JWehle/jannett-kicad-libraries/README.md

# jannett-kicad-libraries
Footprint and symbol libraries for my KiCad projects.
