JWehle/jannett-kicad-libraries/jannett_3d_models/RCJ-024.step

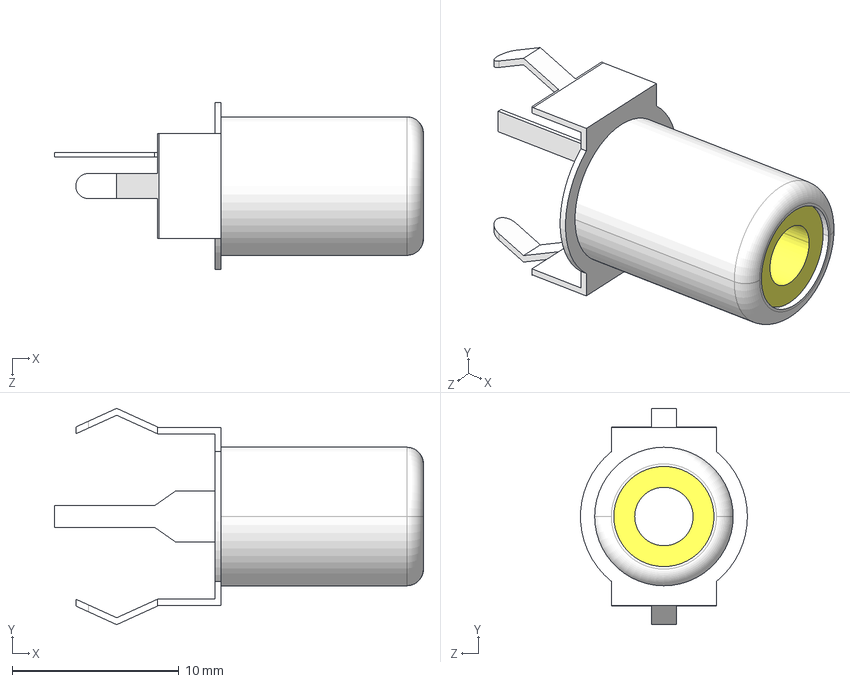
[picture p2: CAD file, 2026-07-09]
jannett_3d_models/RCJ-024.step
22.1 x 13.0 x 9.99 mm
