JWehle/jannett-kicad-libraries/jannett_3d_models/EPC2204.step

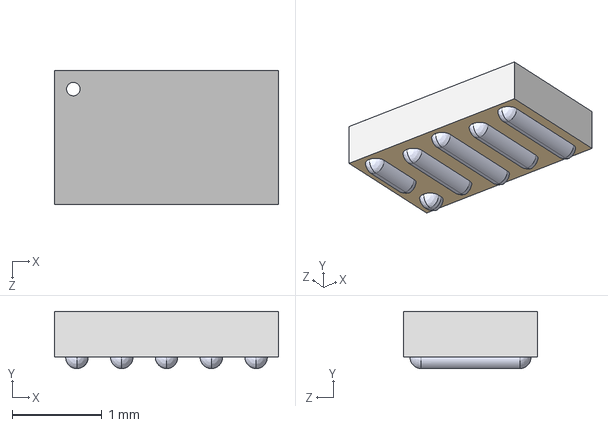
[picture p3: CAD file, 2026-03-19]
jannett_3d_models/EPC2204.step
2.50 x 0.638 x 1.50 mm
