JWehle/jannett-kicad-libraries/jannett_3d_models/EPC2218A.step

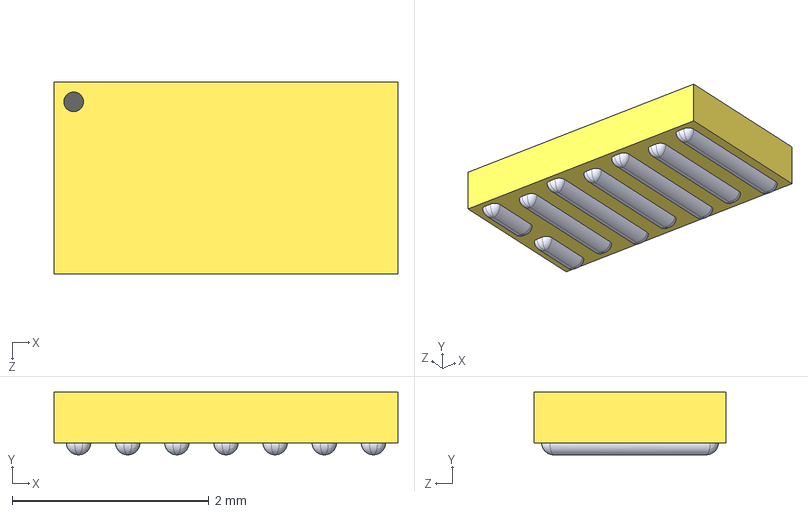
[picture p4: CAD file, 2026-03-19]
jannett_3d_models/EPC2218A.step
3.50 x 0.638 x 1.95 mm
