JWehle/jannett-kicad-libraries/jannett_3d_models/LTC7891RUFDM_TRPBF.step

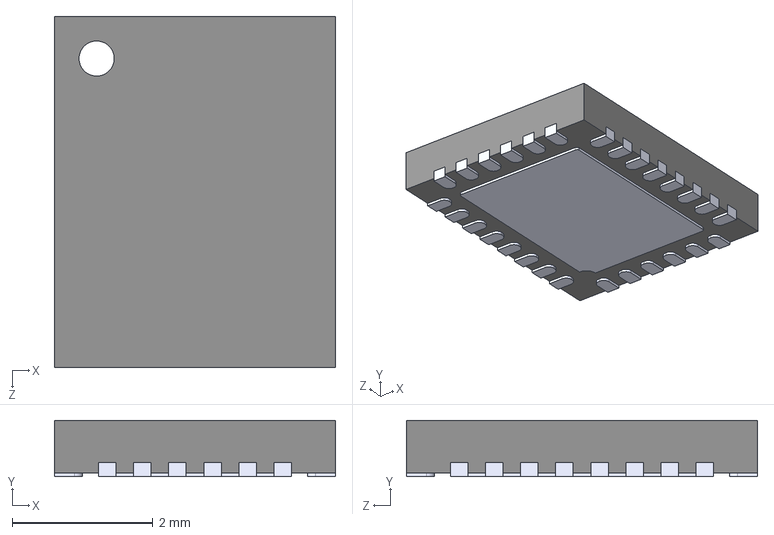
[picture p5: CAD file, 2026-03-19]
jannett_3d_models/LTC7891RUFDM_TRPBF.step
4.00 x 0.8 x 5.00 mm
