JWehle/jannett-kicad-libraries/jannett_3d_models/LD15-23BxxR2_MNS.step

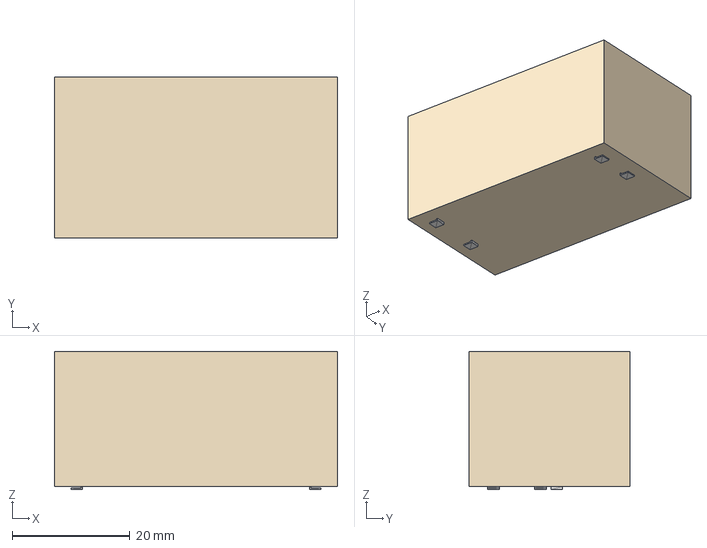
[picture p6: CAD file, 2025-06-29]
jannett_3d_models/LD15-23BxxR2_MNS.step
48.1 x 27.3 x 23.5 mm
