JWehle/jannett-kicad-libraries/jannett_3d_models/PHVL-3R9H305-R.stp

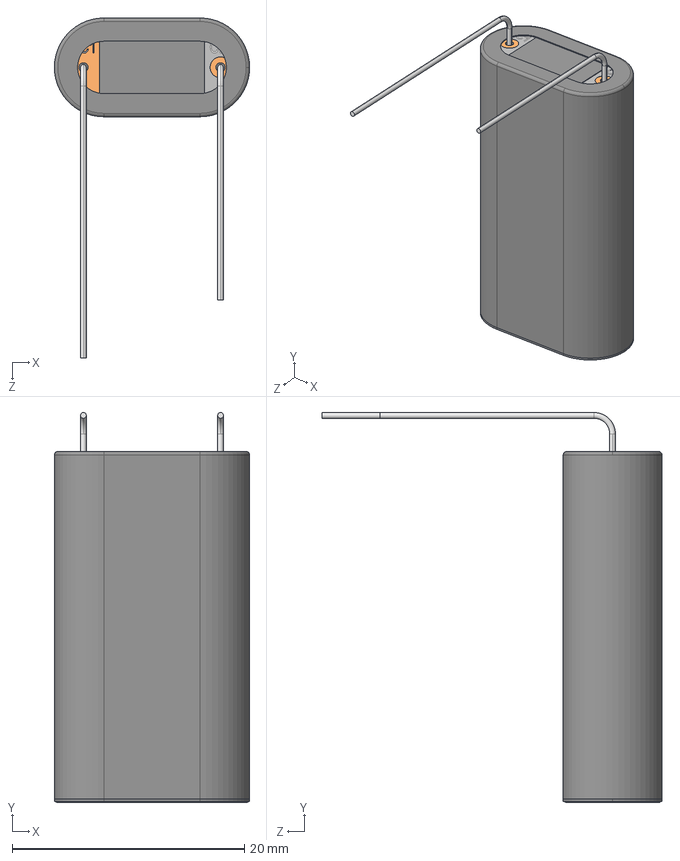
[picture p7: CAD file, 2025-01-18]
jannett_3d_models/PHVL-3R9H305-R.stp
16.8 x 33.5 x 29.2 mm
