JWehle/jannett-kicad-libraries/jannett_3d_models/M138_MODEM.step

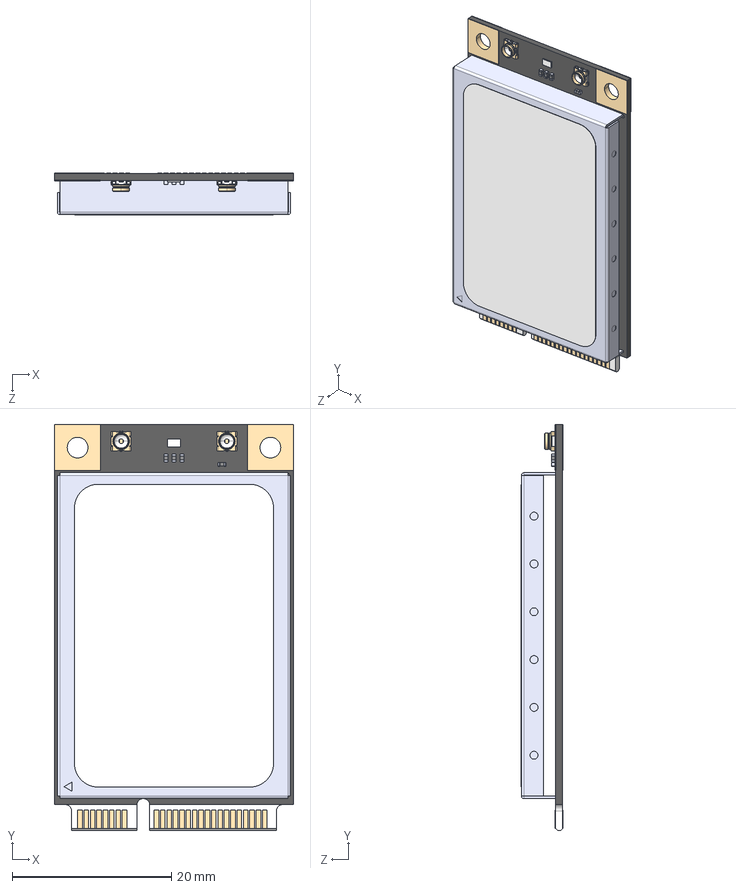
[picture p8: CAD file, 2025-01-18]
jannett_3d_models/M138_MODEM.step
30.0 x 51.0 x 5.30 mm
