JWehle/jannett-kicad-libraries/jannett_3d_models/5016.step

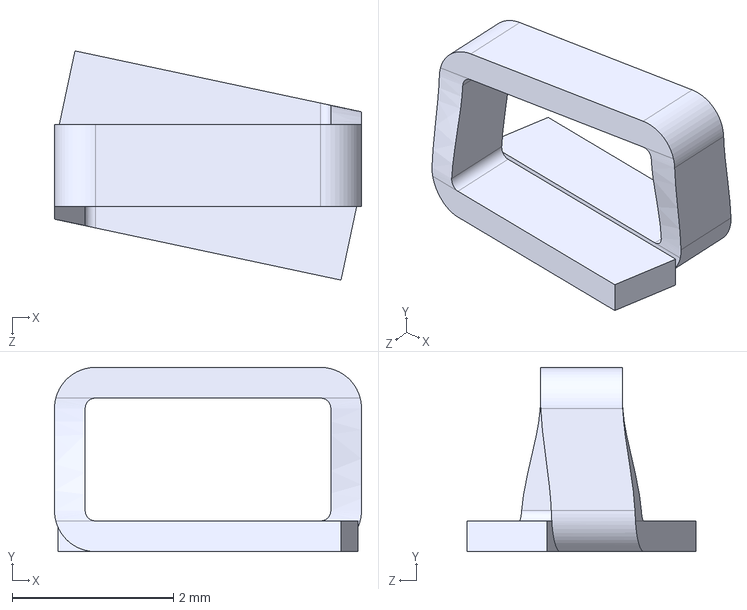
[picture p9: CAD file, 2025-01-18]
jannett_3d_models/5016.step
3.81 x 2.29 x 2.84 mm
