JWehle/jannett-kicad-libraries/jannett_3d_models/MIMXRT1062DVL6A.step

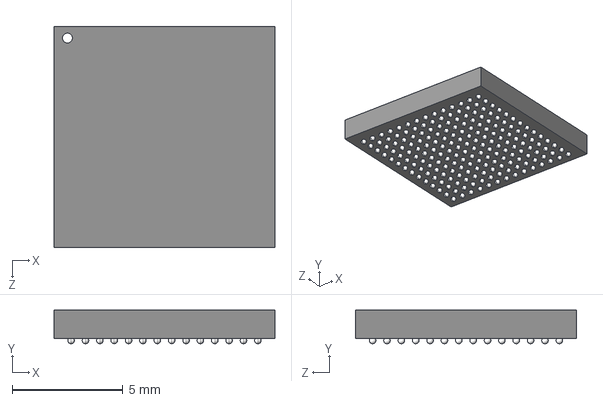
[picture p10: CAD file, 2025-01-18]
jannett_3d_models/MIMXRT1062DVL6A.step
10.0 x 1.52 x 10.0 mm
