JWehle/jannett-kicad-libraries/jannett_3d_models/XT60FemaleConnector.STEP

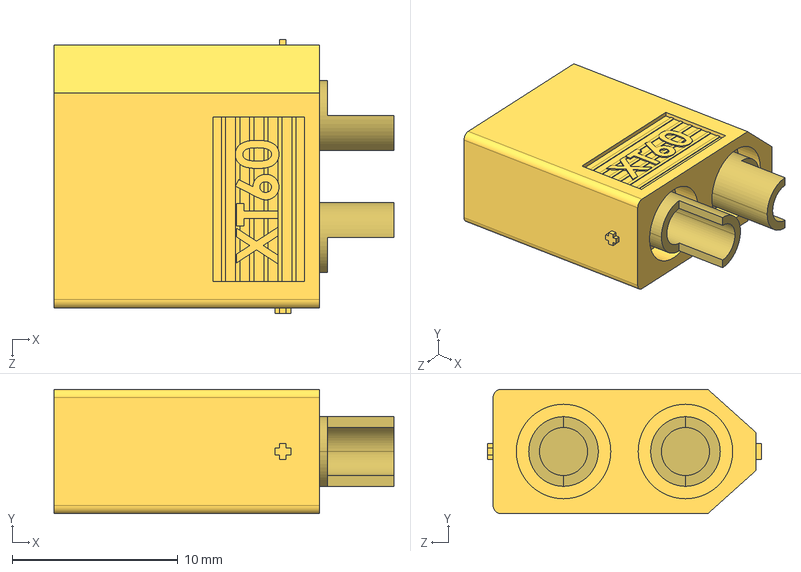
[picture p11: CAD file, 2025-01-18]
jannett_3d_models/XT60FemaleConnector.STEP
20.5 x 7.50 x 16.5 mm
