JWehle/jannett-kicad-libraries/jannett_3d_models/XT60MaleConnector.STEP

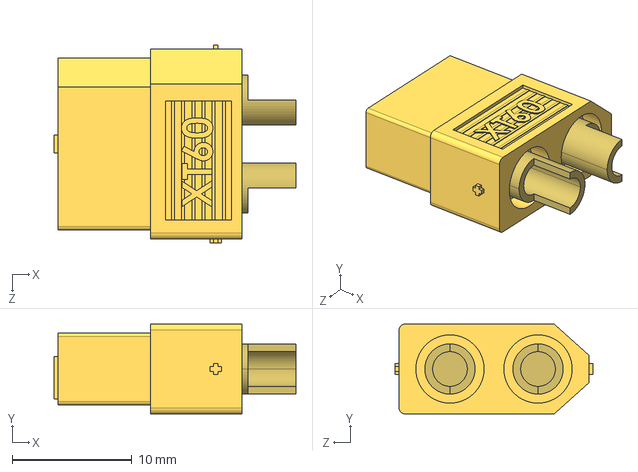
[picture p13: CAD file, 2025-01-18]
jannett_3d_models/XT60MaleConnector.STEP
20.2 x 7.50 x 16.5 mm
