JWehle/jannett-kicad-libraries/jannett_3d_models/54-00023.step

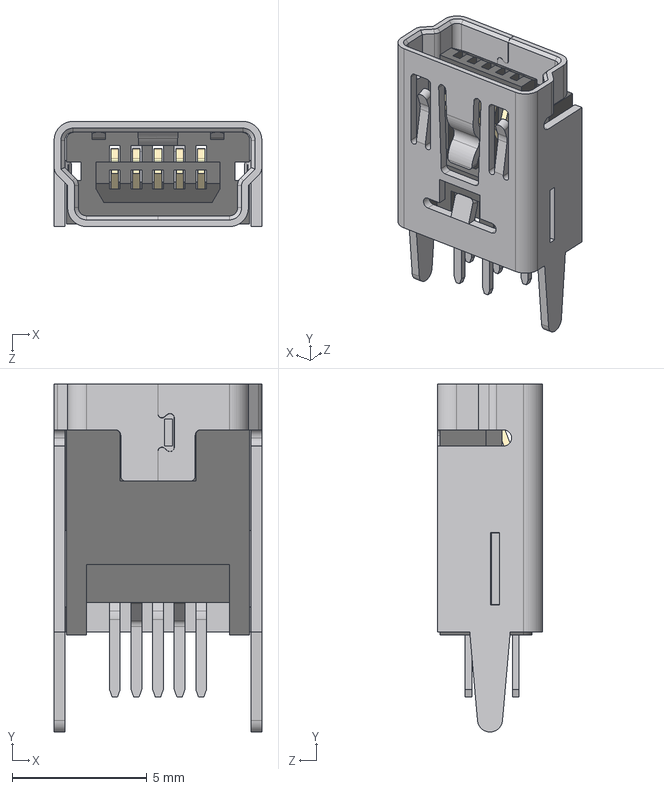
[picture p14: CAD file, 2025-01-18]
jannett_3d_models/54-00023.step
7.70 x 12.9 x 3.90 mm
54-00023_shell
54-00023_insulator
54-00023_pin4
54-00023_pin2
54-00023_pin3
54-00023_pin1
54-00023_pin5
