JWehle/jannett-kicad-libraries/jannett_3d_models/181-026-213.STEP

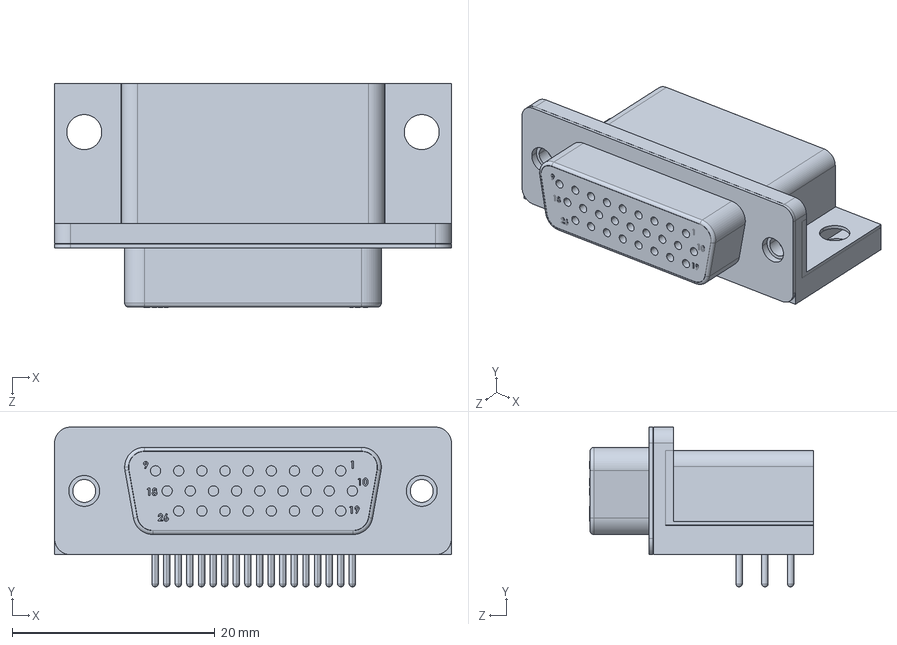
[picture p15: CAD file, 2025-01-18]
jannett_3d_models/181-026-213.STEP
39.2 x 15.8 x 22.1 mm
