JWehle/jannett-kicad-libraries/jannett_3d_models/Switch-CK-KMR2.STEP

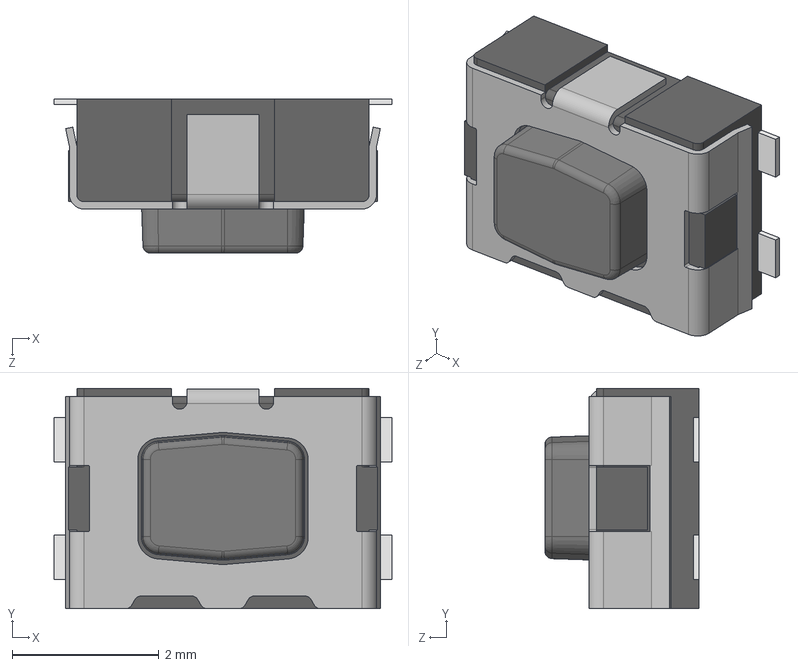
[picture p16: CAD file, 2025-01-18]
jannett_3d_models/Switch-CK-KMR2.STEP
4.60 x 3.00 x 2.10 mm
Button
Boitier
Tole
Pads
