JWehle/jannett-kicad-libraries/jannett_3d_models/Coilcraft-MSS1278.step

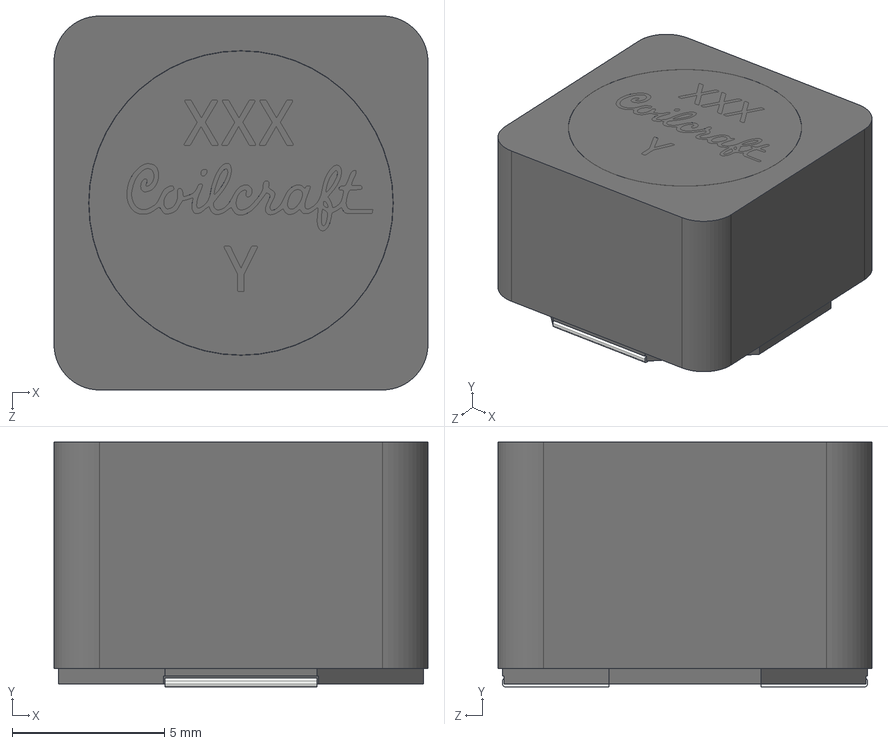
[picture p17: CAD file, 2025-01-18]
jannett_3d_models/Coilcraft-MSS1278.step
12.3 x 8.05 x 12.3 mm
