JWehle/jannett-kicad-libraries/jannett_3d_models/LFCSP32_CP-32-17_ADI.step

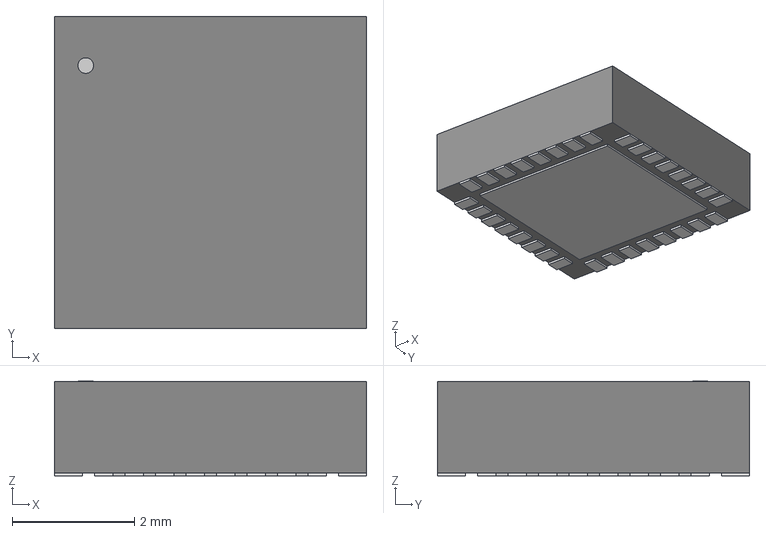
[picture p18: CAD file, 2025-01-18]
jannett_3d_models/LFCSP32_CP-32-17_ADI.step
5.11 x 5.11 x 1.55 mm
