JWehle/jannett-kicad-libraries/jannett_3d_models/URB2412LD-60WR3.STEP

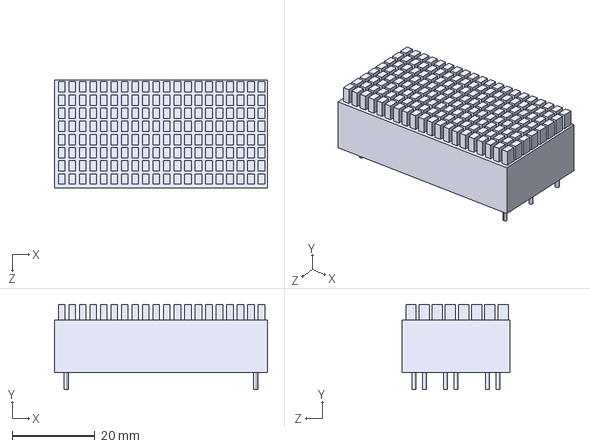
[picture p19: CAD file, 2025-01-18]
jannett_3d_models/URB2412LD-60WR3.STEP
51.4 x 20.6 x 26.2 mm
