JWehle/jannett-kicad-libraries/jannett_3d_models/POWERPAK_1212_8.step

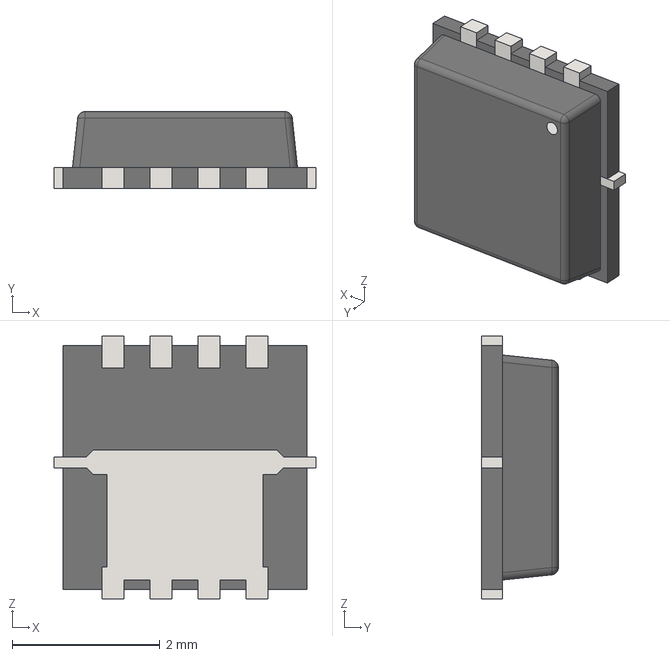
[picture p20: CAD file, 2025-01-18]
jannett_3d_models/POWERPAK_1212_8.step
3.55 x 1.04 x 3.56 mm
