JWehle/jannett-kicad-libraries/jannett_3d_models/L77HDAH26SOL2RM8.STEP

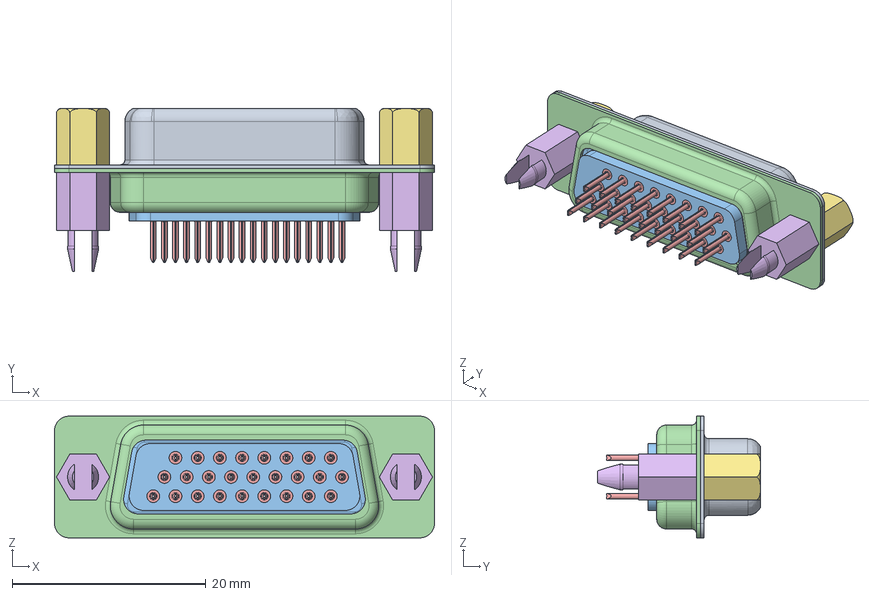
[picture p21: CAD file, 2025-01-18]
jannett_3d_models/L77HDAH26SOL2RM8.STEP
39.2 x 16.8 x 12.6 mm
