JWehle/jannett-kicad-libraries/jannett_3d_models/54-00178.step

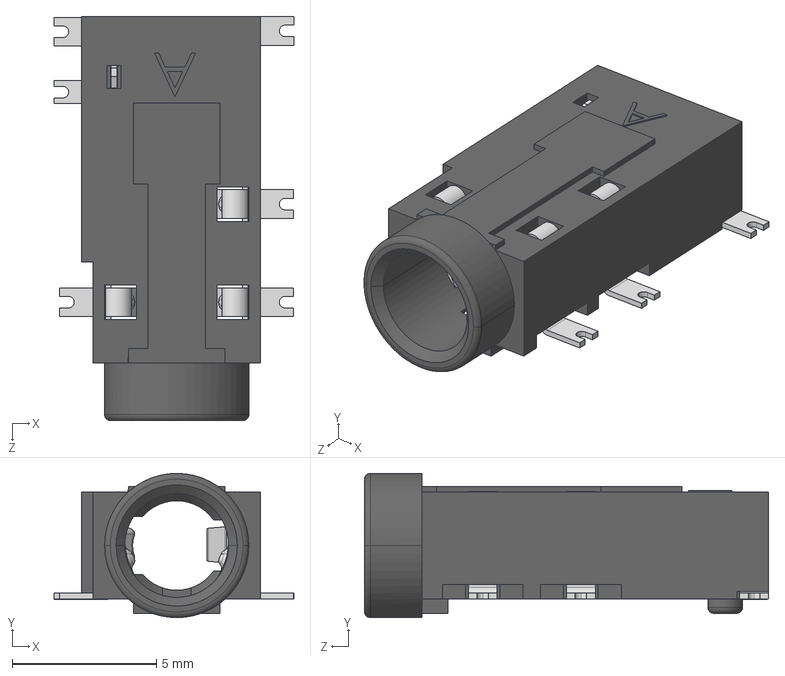
[picture p22: CAD file, 2025-01-18]
jannett_3d_models/54-00178.step
8.30 x 5.00 x 14.0 mm
