JWehle/jannett-kicad-libraries/jannett_3d_models/USB-B1HSB6.step

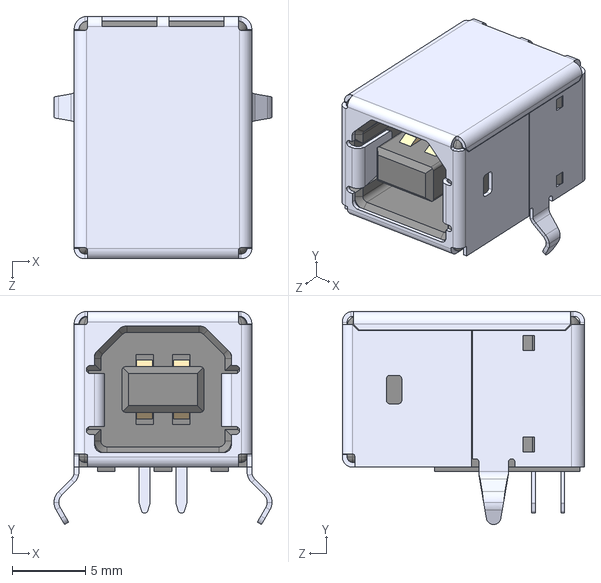
[picture p23: CAD file, 2025-01-18]
jannett_3d_models/USB-B1HSB6.step
14.8 x 14.5 x 16.5 mm
