JWehle/jannett-kicad-libraries/jannett_3d_models/1-1734248-5.step

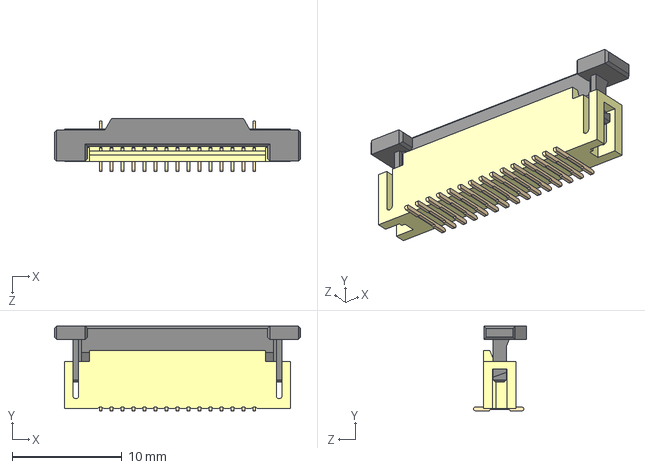
[picture p24: CAD file, 2025-01-18]
jannett_3d_models/1-1734248-5.step
22.4 x 7.70 x 4.85 mm
