JWehle/jannett-kicad-libraries/jannett_3d_models/DCCM21PBSPN.stp

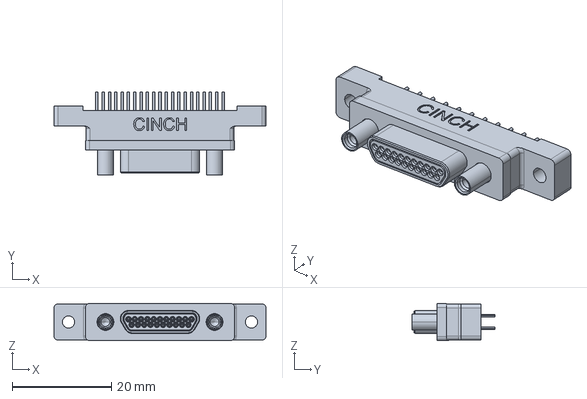
[picture p25: CAD file, 2025-01-18]
jannett_3d_models/DCCM21PBSPN.stp
42.7 x 16.6 x 7.50 mm
