JWehle/jannett-kicad-libraries/jannett_3d_models/URF2415LP-10WR3.STEP

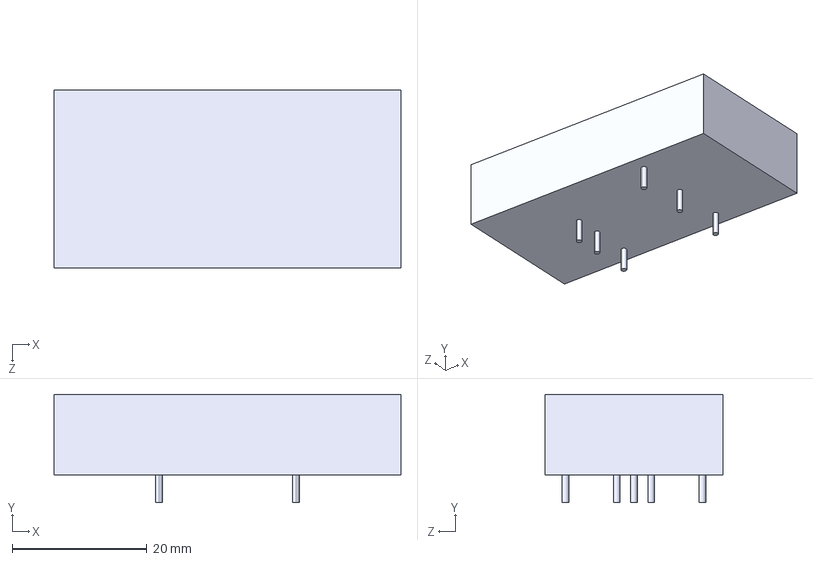
[picture p26: CAD file, 2025-01-18]
jannett_3d_models/URF2415LP-10WR3.STEP
51.5 x 16.1 x 26.5 mm
