JWehle/jannett-kicad-libraries/jannett_3d_models/EFB0612HA.stp

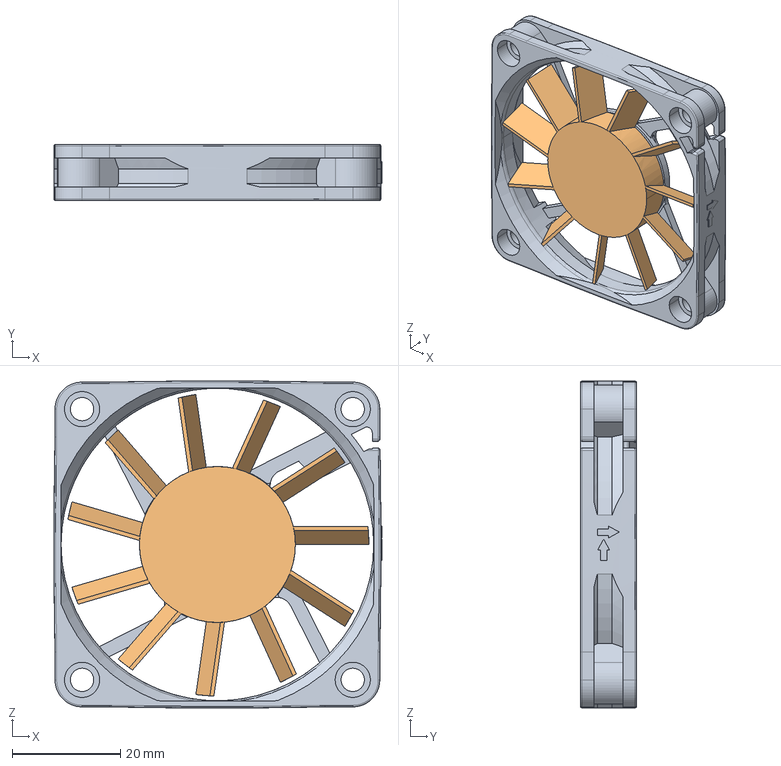
[picture p27: CAD file, 2025-01-18]
jannett_3d_models/EFB0612HA.stp
60.6 x 10.4 x 60.4 mm
