JWehle/jannett-kicad-libraries/jannett_3d_models/TL3305CF260QG.stp

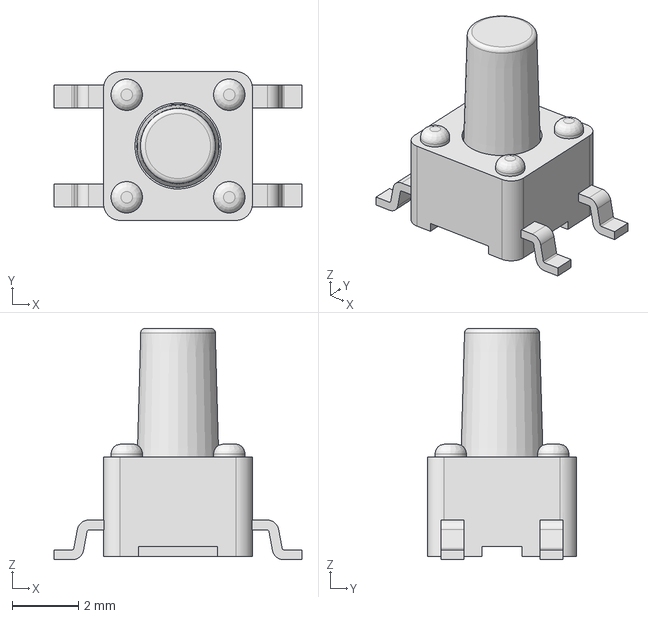
[picture p28: CAD file, 2025-01-18]
jannett_3d_models/TL3305CF260QG.stp
7.50 x 4.50 x 7.00 mm
