JWehle/jannett-kicad-libraries/jannett_3d_models/USB_MALE_A_480370001.stp

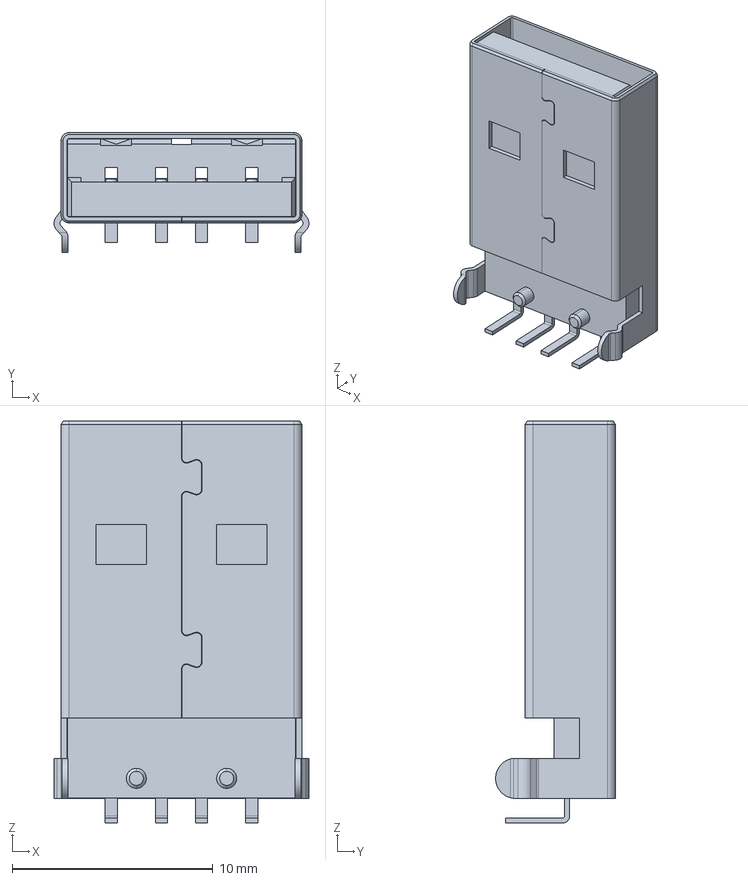
[picture p29: CAD file, 2025-01-18]
jannett_3d_models/USB_MALE_A_480370001.stp
12.7 x 5.97 x 20.0 mm
