JWehle/jannett-kicad-libraries/jannett_3d_models/Terminal_10A_Keystone_8191.STEP

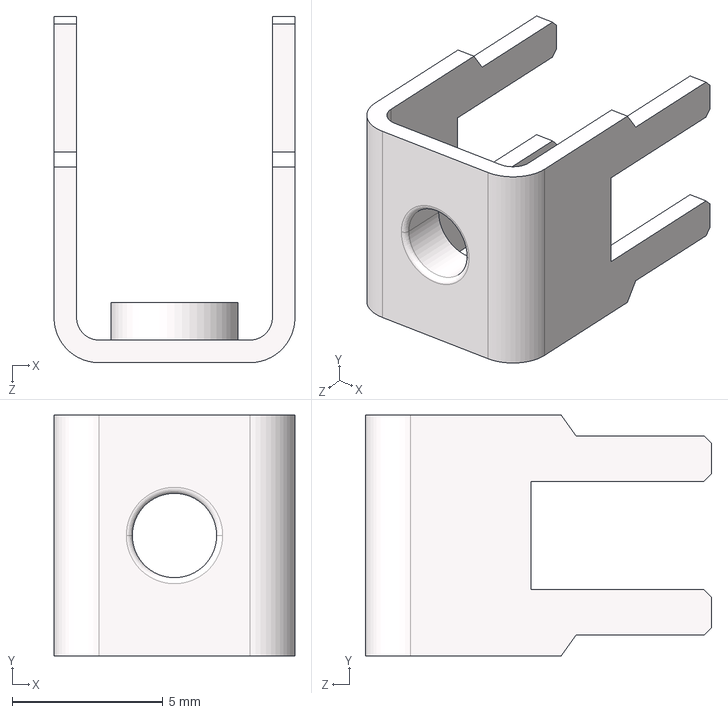
[picture p30: CAD file, 2025-01-18]
jannett_3d_models/Terminal_10A_Keystone_8191.STEP
8.00 x 8.00 x 11.5 mm
