JWehle/jannett-kicad-libraries/(list of files, cad)

Other CAD files:
jannett_3d_models/0676430910.stp
jannett_3d_models/10090926-P15.stp
jannett_3d_models/103906-1.step
jannett_3d_models/1050570001.stp
jannett_3d_models/504618-2412.step
jannett_3d_models/714360164.stp
jannett_3d_models/JS202011JCQN.step
jannett_3d_models/PTR08060WVD.STEP
