JWehle/jannett-kicad-libraries/(commit log)

2025-01-25 plante footprint
2025-02-10 added SKC6812RV footprint, no silk
2025-02-15 added 0305 kailh switch
2025-03-08 added amazon reset button
2025-06-29 LD15-23B03R2
    AC/DC CONVERTER 3.3V 13W
    [LD15-23BxxR2_MNS.step]
2026-02-20 fixed esp32 footprint
2026-03-19 added LTC7891
    [LTC7891RUFDM_TRPBF.step]
2026-03-19 added GAN FETs
    EPC2204 and EPC2218A
    [EPC2204.step, EPC2218A.step]
